EIT-team/AD9954_Current_Source/README.md

# AD9954 communication library

Communication over a serial port to program Analog Devices AD9954 DDS chip.

Arduino source code in _/Program_AD9954_.

Sample MATLAB code for programming over Serial port in _sample_code.m_

Serial commands:

  _frequency xxxx_      frequency to program (Hz)

  _stim 1_              Starts injection
  
  _stim 0_              Stops injection
