EIT-team/AD9954_Current_Source/ref/AD9954/tinadiag.jpg

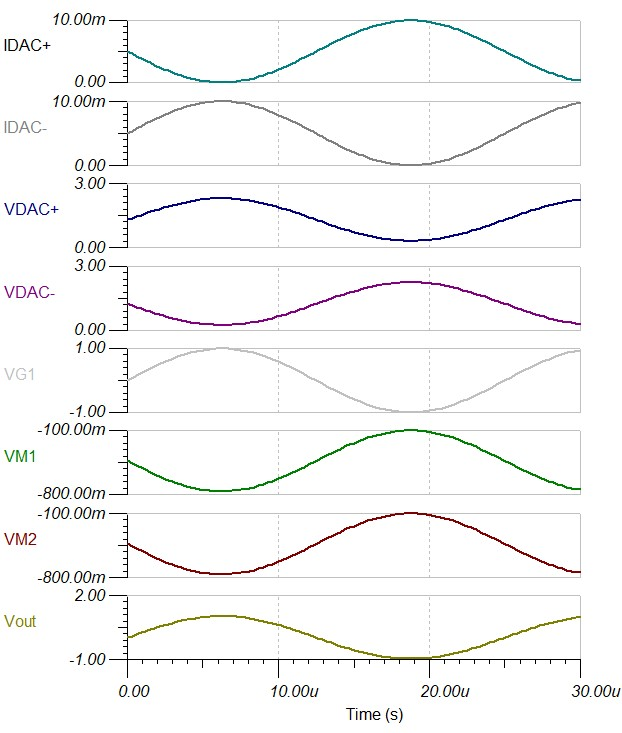
ref/AD9954/tinadiag.jpg
