EIT-team/AD9954_Current_Source/ref/AD9954/192593130AD9859_RevD_BOM_Pb_Free.xls

AD9859 REV. D-(1.0) EVALUATION BOARD Pb-Free BILL OF MATERIALS 2/08/07
ITEM | QTY | REFDES | DEVICE | PACKAGE | VALUE | MIN TOL | MFR | MFR P/N | VENDOR / DIST | P/N | COMMENTS | Pb-FREE? | BOARD ASSEMBLER Temporary Waiver
1 | 29 | C1,C2,C3, | CAP0402 | 0402 | 0.1UF, 16V, X7R | 10% | Murata | GRM155R71C104KA88D |  |  | Any Pb-Free Mfr OK | Mfr info states Yes
 |  | C4,C5,C6,
 |  | C7,C8,C9,
 |  | C10,C11,
 |  | C12,C13,
 |  | C14,C15,
 |  | C16,C17,
 |  | C18,C19,
 |  | C20,C21,
 |  | C22,C23,
 |  | C24,C68,
 |  | C69,C70,
 |  | C71,C72
2 | 4 | C25,C26, | TAJC | TAJC | 10UF, 16V, TAJ | 10% | AVX | TAJC106K016R |  |  | Any Pb-Free Mfr OK | Mfr info states Yes
 |  | C27,C28
3 | 4 | C29,C38, | CAP0805 | 0805 | 33 pF, 50 V, NPO | 5% | YAGEO | CC0805JRNPO9BN330 |  |  | Any Pb-Free Mfr OK | Mfr info states Yes
 |  | C43,C56
4 | 4 | C30,C50, | CAP0402 | 0402 | 13PF, 50V, COG | 5% | ROHM | MCH155A130JK |  |  | Any Pb-Free Mfr OK | Mfr info states Yes
 |  | C53,C59
5 | 2 | C31,C57 | CAP0805 | 0805 | 27 pF, 50V, NPO | 5% | YAGEO | CC0805JRNPO9BN270 |  |  | Any Pb-Free Mfr OK | Mfr info states Yes
6 | 5 | C32,C37, | CAP0805 | 0805 | 22 pF, 50 V, NPO | 5% | YAGEO | CC0805JRNPO9BN220 |  |  | Any Pb-Free Mfr OK | Mfr info states Yes
 |  | C41,C45,
 |  | C55
7 | 2 | C34,C61 | CAP0805 | 0805 | .01UF, 50V, X7R | 10% | KEMET | C0805C103K5RACTU
8 | 3 | C40,C42, | CAP0805 | 0805 | 39 pF, 50 V, NPO | 5% | YAGEO | CC0805JRNPO9BN390 |  |  | Any Pb-Free Mfr OK | Mfr info states Yes
 |  | C44
9 | 2 | C39,C46 | CAP1206 | 1206 | 7.5PF, 50 V, NPO | 0.5 PF | KEMET | C1206C759D5GACTU |  |  | Any Pb-Free Mfr OK | Mfr info states Yes
10 | 2 | C47,C62 | CAP0805 | 0805 | 1UF, 25V, X5R | 10% | Murata | GRM216R61E105KA12D |  |  | Any Pb-Free Mfr OK | Mfr info states Yes
11 | 4 | C48,C49, | CAP0805 | 0805 | 12 pF, 50 V, NPO | 5% | YAGEO | CC0805JRNPO9BN120 |  |  | Any Pb-Free Mfr OK | Mfr info states Yes
 |  | C63,C64
12 | 2 | C51,C54 | CAP1206 | 1206 | 2.2 pF, 50 V, NPO | 0.25 pF | YAGEO | CC1206CRNPO9BN2R2 |  |  | Any Pb-Free Mfr OK | Mfr info states Yes
13 | 2 | C52,C60 | CAP1206 | 1206 | 6.8 pF, 50 V, NPO | 0.5 pF | YAGEO | CC1206DRNPO9BN6R8 |  |  | Any Pb-Free Mfr OK | Mfr info states Yes
14 | 8 | J1,J2,J3, | SMA | SMA | N/A | N/A | Johnson Components | 142-0701-231 |  |  | Any Pb-Free Mfr OK | Mfr info states Yes
 |  | J4,J6,
 |  | J7,
 |  | J12,
 |  | J14
15 | 2 | L1,L10 |  | 1008HQ | 39 nH | 2% | Coilcraft | 1008HQ-39NXGLB |  |  | Make sure the part #'s are lead free
 |  |  |  |  |  |  |  |  |  |  | Make sure the part #'s are lead free
16 | 2 | L2,L12 |  | 1008HQ | 56 nH | 2% | Coilcraft | 1008HQ-56NXGLB |  |  | Make sure the part #'s are lead free
 |  |  |  |  |  |  |  |  |  |  | Make sure the part #'s are lead free
17 | 2 | L3,L11 |  | 1008HQ | 68 nH | 2% | Coilcraft | 1008HQ-68NXGLB |  |  | Make sure the part #'s are lead free
 |  |  |  |  |  |  |  |  |  |  | Make sure the part #'s are lead free
18 | 2 | L4,L7 |  | 0805HQ | 18NH | 5% | Coilcraft | 0805HQ-18NXJLB |  |  | Make sure the part #'s are lead free
 |  |  |  |  |  |  |  |  |  |  | Make sure the part #'s are lead free
19 | 2 | L5,L9 |  | 0805HQ | 12NH | 5% | Coilcraft | 0805HQ-12NXJLB |  |  | Make sure the part #'s are lead free
 |  |  |  |  |  |  |  |  |  |  | Make sure the part #'s are lead free
20 | 2 | L6,L8 |  | 0805HQ | 20NH | 5% | Coilcraft | 0805HQ-20NXJLB |  |  | Make sure the part #'s are lead free
21 | 7 | R1,R8, | RES_SM | 1206 | 49.9, 1/4W | 1% | Panasonic-ECG | ERJ-8ENF49R9V |  |  | Any Pb-Free Mfr OK | Mfr info states Yes
 |  | R9,R14,
 |  | R18,
 |  | R22,R23
22 | 2 | R3,R16 | RES_SM | 1206 | 243, 1/4 W | 1% | Panasonic-ECG | ERJ-8ENF2430V |  |  | Any Pb-Free Mfr OK | Mfr info states Yes
23 | 2 | R6, R7 | RES_SM | 1206 | 0, 1/4 W | 5% | Panasonic-ECG | ERJ-8GEY0R00V |  |  | Any Pb-Free Mfr OK | Mfr info states Yes
24 | 2 | R10,R15 | RES_SM | 0603 | 3.92 K, 1/10 W | 1% | Panasonic-ECG | ERJ-3EKF3921V |  |  | Any Pb-Free Mfr OK | Mfr info states Yes
25 | 4 | R33,R34, | RES_SM | 1206 | 10K, 1/4 W | 1% | Panasonic-ECG | ERJ-8ENF1002V |  |  | Any Pb-Free Mfr OK | Mfr info states Yes
 |  | R35,R37
26 | 2 | T1,T4 | ETC1_1_13 | SM22 | 1:1, 4.5-3000MHz | N/A | Tyco/M/A-COM | MABA-007159-000000 | First Source | Ph: 800-225-7434 | RF Balun (Replacement for Non-RoHS ETC1-1T-5) | Mfr info states Yes, Long lead time (?)
27 | 2 | T2,T3 | TFORM | KK81 | 1:1, 0.08-300MHz | N/A | Mini-Circuits | T1-1T-KK81+ |  |  | RF Transformer | "+" = Pb-Free
28 | 1 | U3 | TB5 | TB5 | 5 PIN |  | Weiland | Terminal Strip Z5.530.3525.0 |  |  | Order Plug and Terminal Strip (2 Items) | Mfr info states Yes
 |  |  |  |  |  |  | Weiland | Plug 25.602.2553.0
29 | 1 | U4 | C36CRPX | 36CRP | N/A | N/A | TYCO Electronics | 5552742-1 |  |  |  | Mfr info states Yes
30 | 1 | U6 | 74LVC125A | TSSOP14 | N/A | N/A | Texas Instruments | SN74LVC125APW | Digi-Key |  | Any Pb-Free Mfr OK | Mfr info states Yes
31 | 2 | U7,U8 | AD9859 | 48 Lead TQFP | N/A | N/A | Analog Devices, Inc. | AD9859YSVZ |  |  |  | Mfr info states Yes
32 | 3 | U9,U10,U11 | 74LVC574APW | TSSOP20 | N/A | N/A | Texas Instruments | SN74LVC574APW | Digi-Key |  |  | Mfr info states Yes
33 | 1 | U12 | 74LVC14A | TSSOP14 | N/A | N/A | Texas Instruments | SN74LVC14APW | Digi-Key |  | Any Pb-Free Mfr OK | Mfr info states Yes
34 | 1 | U13 | 50PINHEAD | HEADER | N/A | N/A | Samtec | TSW-125-23-L-D |  |  |  | Mfr info states Yes
35 | 2 | W1,W3 | SMT TERM STP | NORM_J | N/A | N/A | Samtec | TSM-102-01-L-DV |  |  |  | Mfr info states Yes
36 | 1 | W2 | 3PINHDR | SIP-3P | N/A | N/A | Samtec | TSW-103-07-S-S |  |  | Header | Mfr info states Yes
37 | 3 | (none) | 2PINHDR | SIP-2P | N/A | N/A | Samtec | TSW-102-07-S-S |  |  | Header (Mount to PC Control Side of W2, Across | Mfr info states Yes
 |  |  |  |  |  |  |  |  |  |  | 1 to 2, of W1, and W3)
38 | 2 | (none) | TEST POINTS |  | N/A | N/A | Keystone Electronics | 5000 | Digi-Key |  | Mount at "SYNC CLK DUT1, SYNC CLK DUT 2" | Mfr info states Yes
39 | 5 | N/A | Adhesive Feet | N/A | Black | N/A | 3M | SJ-5518 | Digi-Key | SJ5518-0-ND | Install on Bottom, 4 Corners, One in PC Board Center | Mfr info states Yes
40 | 1 | N/A | PCB | N/A | N/A | N/A | MOOG Components Grp. | AD9859/PCBZ |  |  |  | Mfr info states Yes
 |  |  |  |  |  |  |  | Eval Board (Rev. D)
