EIT-team/AD9954_Current_Source/(threads)

Thread 1 (2019-06-13):

Rev3 Changes

Jimbles, 2019-06-13:
- Switch to crystal 20 MHz oscillator
- Change DAC values
- Better/smaller 1.8V LDOs?
- Better connection for current output
