EIT-team/AD9954_Current_Source/ref/AD9954/46543170023221AD9954_RevD_schem.pdf

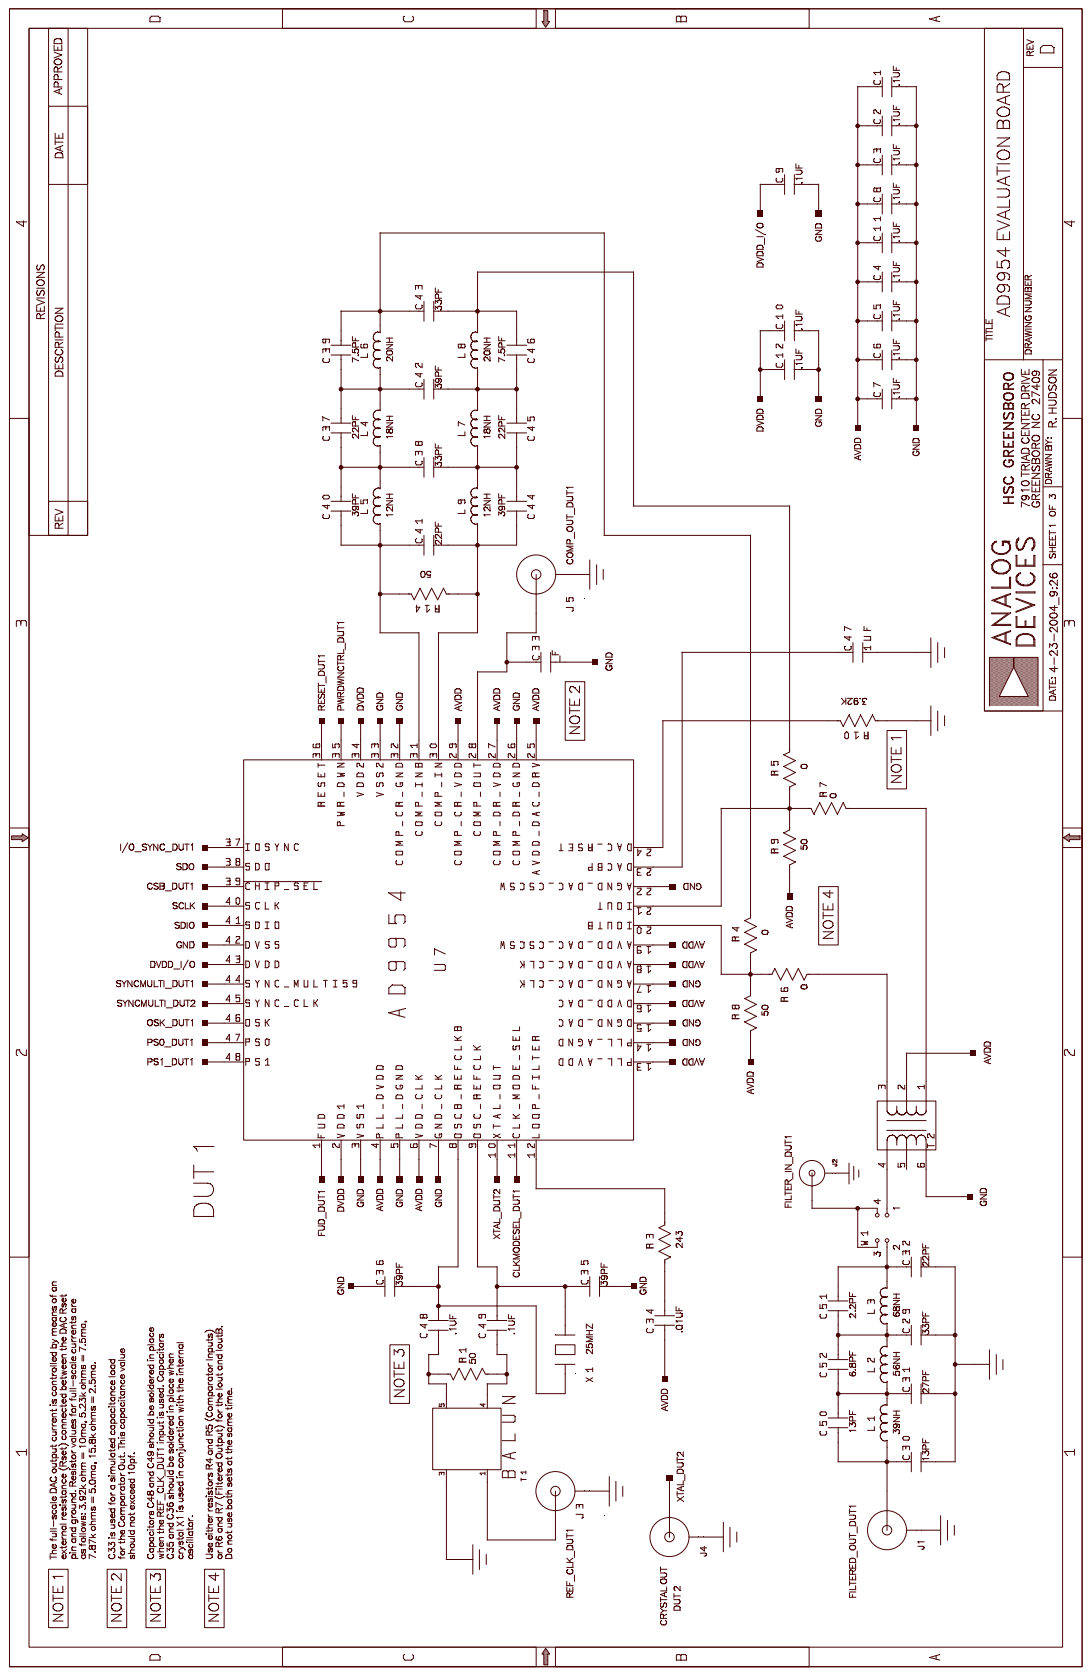
[picture p2: page 1]

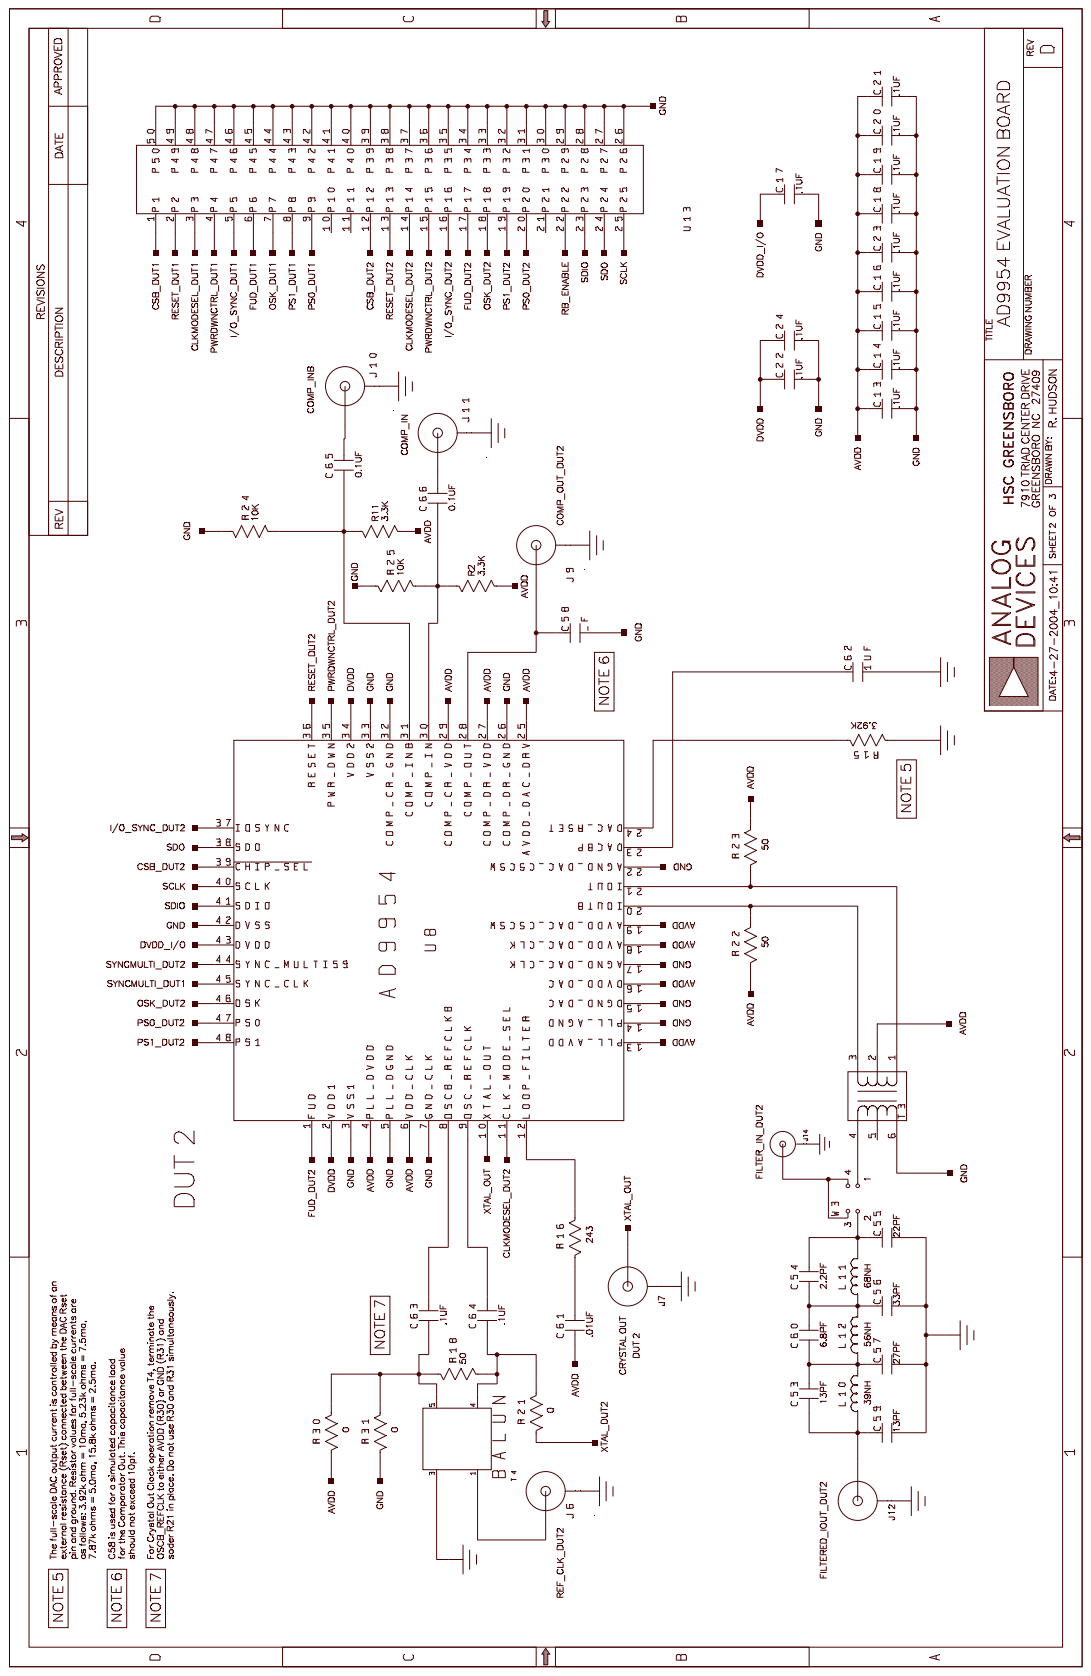
[picture p3: page 2]

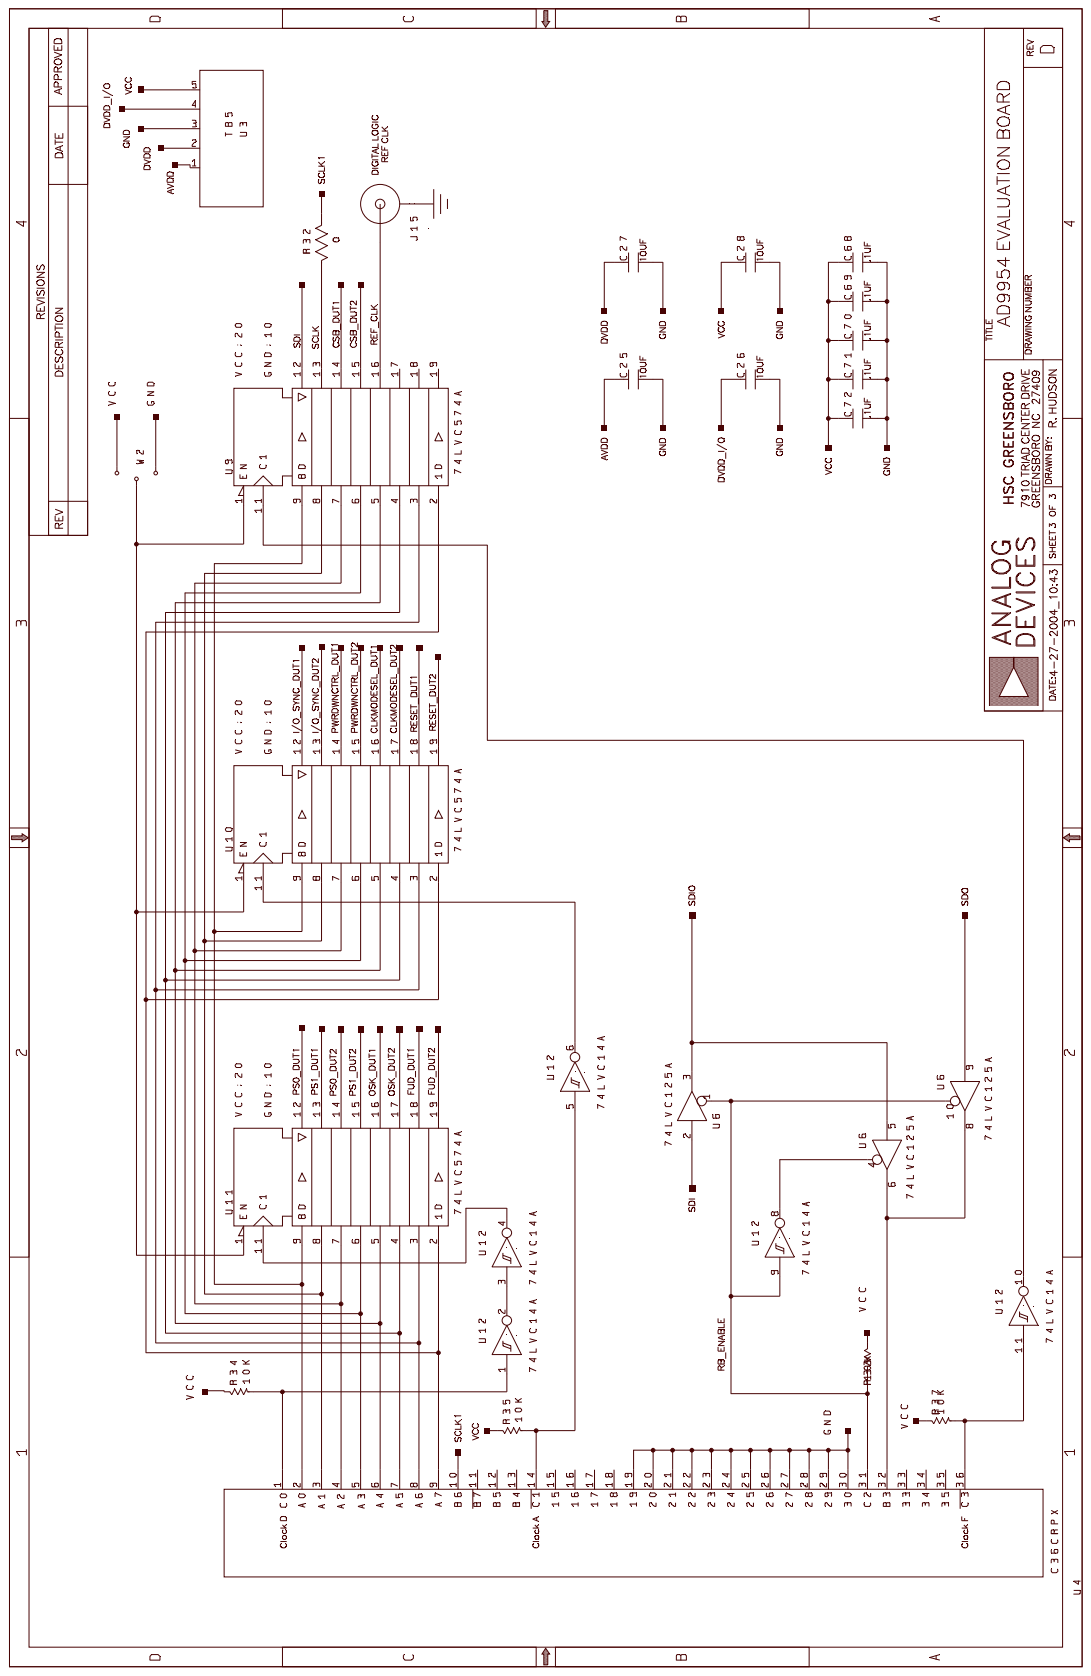
[picture p4: page 3]
