EIT-team/AD9954_Current_Source/ref/AD9954/DAC_Network_Model.asc

I1: current; SINE(2.5m 2.5m 1000 0 0 0)
I2: current; SINE(2.5m 2.5m 1000 0 0 180)
R1: res; 931
R2: res; 1500
R3: res; 750
R4: res; 1150
Rf: res; 750
Rg: res; 1500
Rx: res; 287
Ry: res; 309
U1: opamp
V1: voltage; 3.3
V2: voltage; 1.8
Named nets: 0, Vref, Vout, VDAC+, VDAC-, VIN+, VIN-, VDD
.tran 0 2m 0
.lib opamp.sub
;op 0 2m 0
