EIT-team/AD9954_Current_Source/schematics/rev2/ScouseTom_CS_Shield.brd

## EAGLE design schematics/rev2/ScouseTom_CS_Shield.brd (2019-02-04)

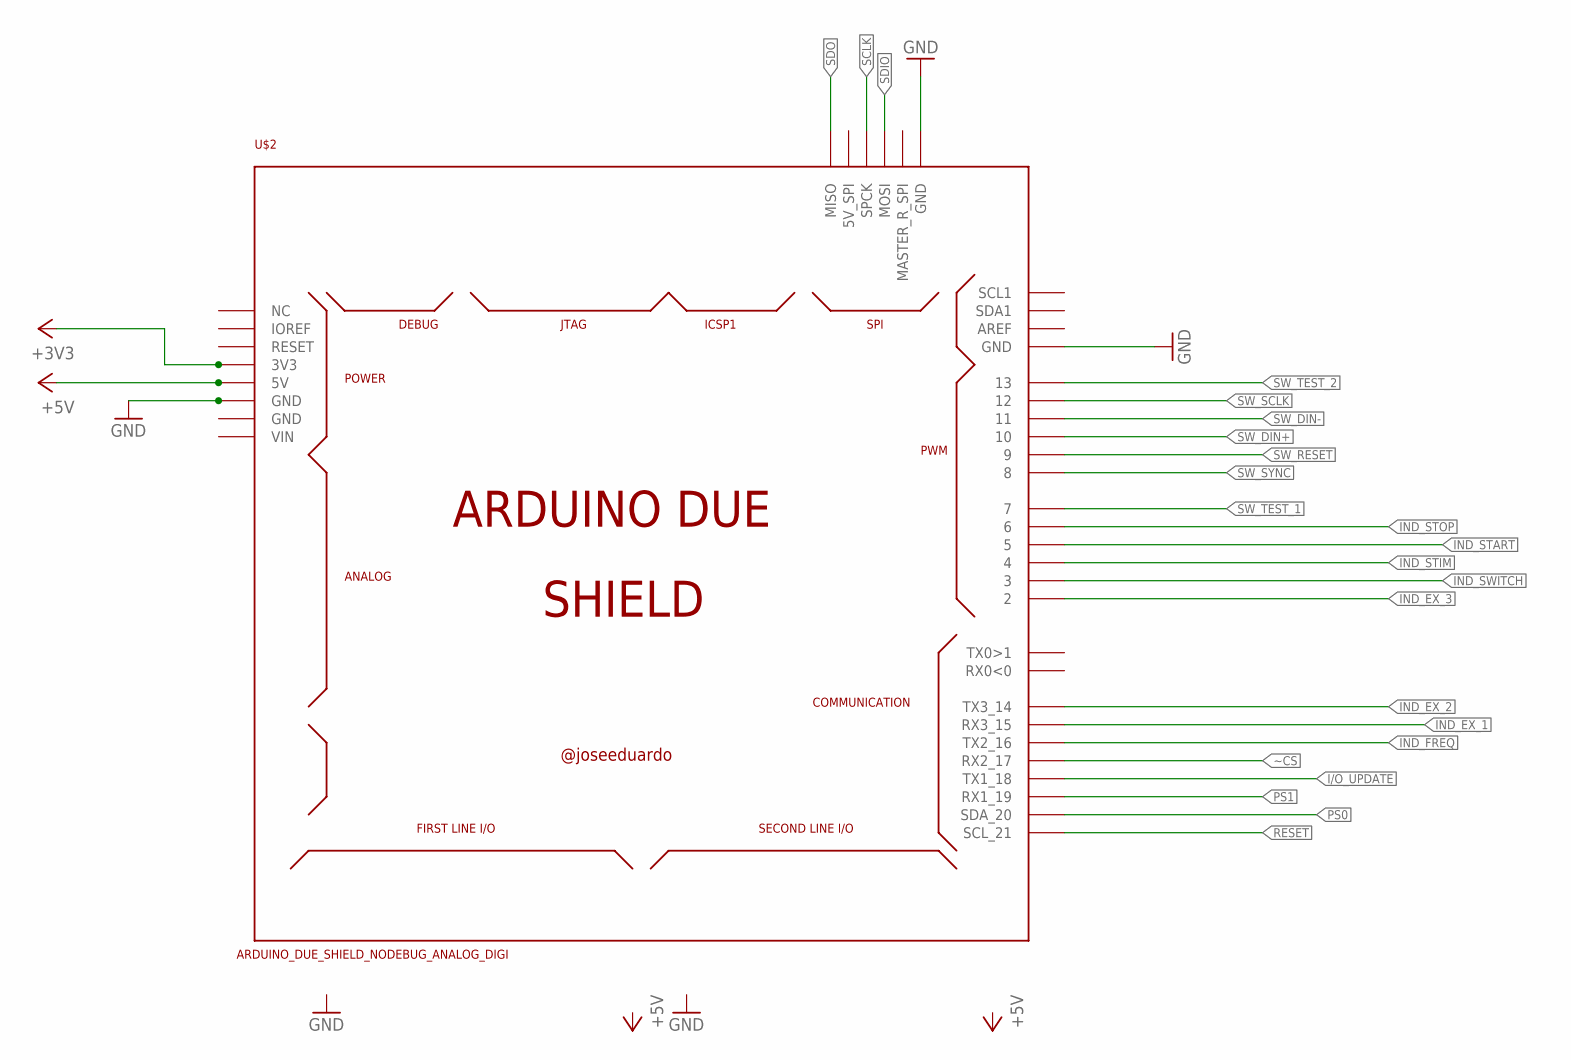
[picture p5: schematic ScouseTom_CS_Shield.sch, sheet 1, Arduino]

Parts:
U$2: ARDUINO_DUE_SHIELD_NODEBUG_ANALOG_DIGI; ARDUINO_DUE_SHIELD_NODEBUG_ANALOG_DIG

Connections:
+3V3: U$2.3V3; also elsewhere on the board
+5V: U$2.5V0 (5V); also elsewhere on the board
GND: U$2.GND, U$2.GND_4 (GND), U$2.GND_5 (GND); also elsewhere on the board
I/O_UPDATE: U$2.18 (TX1_18); also elsewhere on the board
IND_EX_1: U$2.15 (RX3_15); also elsewhere on the board
IND_EX_2: U$2.14 (TX3_14); also elsewhere on the board
IND_EX_3: U$2.2; also elsewhere on the board
IND_FREQ: U$2.16 (TX2_16); also elsewhere on the board
IND_START: U$2.5; also elsewhere on the board
IND_STIM: U$2.4; also elsewhere on the board
IND_STOP: U$2.6; also elsewhere on the board
IND_SWITCH: U$2.3; also elsewhere on the board
PS0: U$2.20 (SDA_20); also elsewhere on the board
PS1: U$2.19 (RX1_19); also elsewhere on the board
RESET: U$2.21 (SCL_21); also elsewhere on the board
SCLK: U$2.SPCK; also elsewhere on the board
SDIO: U$2.MOSI; also elsewhere on the board
SDO: U$2.MISO; also elsewhere on the board
SW_DIN+: U$2.10; also elsewhere on the board
SW_DIN-: U$2.11; also elsewhere on the board
SW_RESET: U$2.9; also elsewhere on the board
SW_SCLK: U$2.12; also elsewhere on the board
SW_SYNC: U$2.8; also elsewhere on the board
SW_TEST_1: U$2.7; also elsewhere on the board
SW_TEST_2: U$2.13; also elsewhere on the board
~CS: U$2.17 (RX2_17); also elsewhere on the board

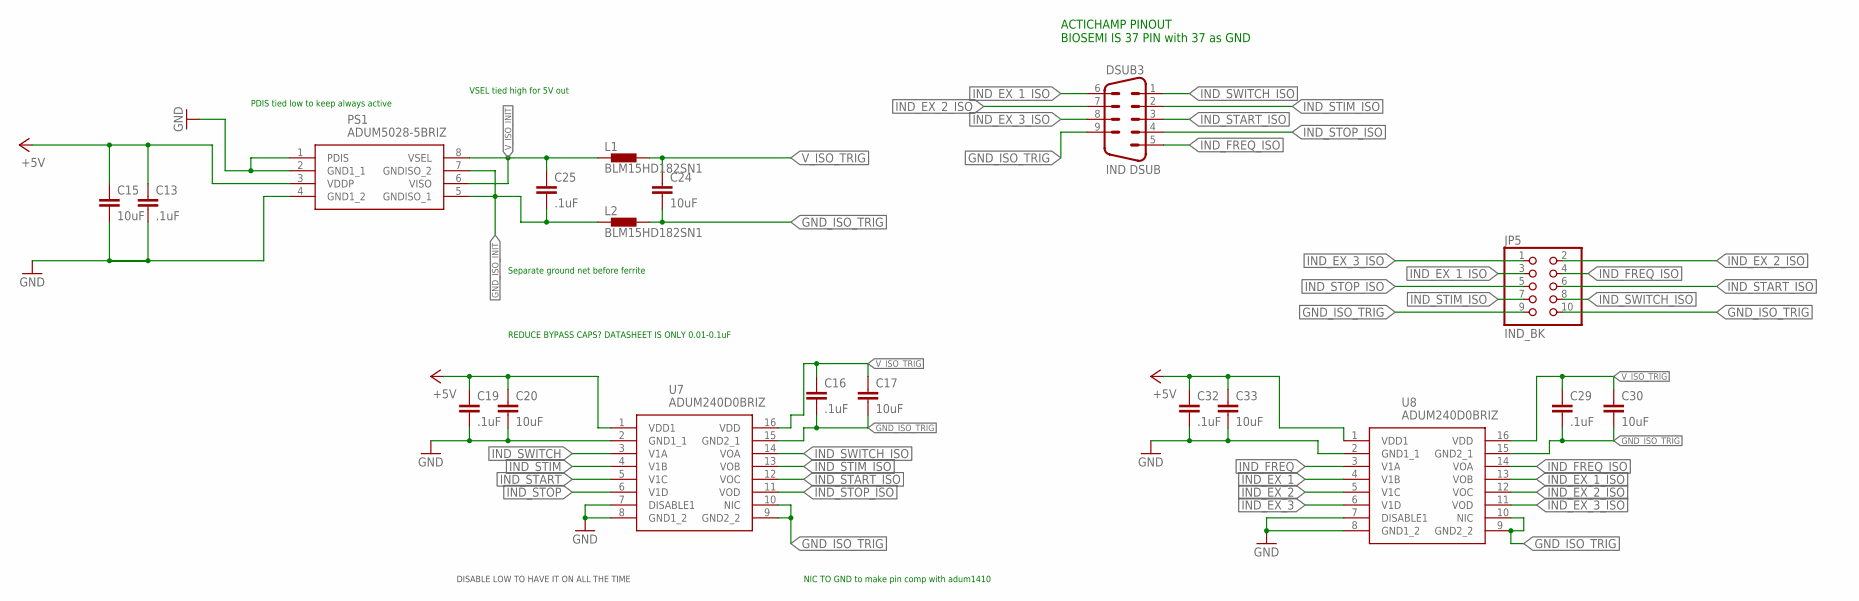
[picture p6: schematic ScouseTom_CS_Shield.sch, sheet 2, Indicators]

Parts:
C13, C16, C19, C25, C29, C32: .1uF; C0805
C15, C17, C20, C24, C30, C33: 10uF; C0805
DSUB3: IND DSUB; DSUB9
JP5: IND_BK; 2X05
L1, L2: BLM15HD182SN1; 0402
PS1: ADUM5028-5BRIZ; SOIC127P1031X265-8N
U7, U8: ADUM240D0BRIZ; SOIC127P1032X265-16N

Connections:
+5V: C13.1, C15.1, C19.1, C20.1, C32.1, C33.1, PS1.3 (VDDP), U7.1 (VDD1), U8.1 (VDD1); also elsewhere on the board
GND: C13.2, C15.2, C19.2, C20.2, C32.2, C33.2, PS1.1 (PDIS), PS1.2 (GND1_1), PS1.4 (GND1_2), U7.2 (GND1_1), U7.7 (DISABLE1), U7.8 (GND1_2), U8.2 (GND1_1), U8.7 (DISABLE1), U8.8 (GND1_2); also elsewhere on the board
GND_ISO_INIT: C25.2, L2.1, PS1.5 (GNDISO_1), PS1.7 (GNDISO_2)
GND_ISO_TRIG: C16.2, C17.2, C24.2, C29.2, C30.2, DSUB3.9, JP5.9, JP5.10, L2.2, U7.9 (GND2_2), U7.10 (NIC), U7.15 (GND2_1), U8.9 (GND2_2), U8.10 (NIC), U8.15 (GND2_1)
IND_EX_1: U8.4 (V1B); also elsewhere on the board
IND_EX_1_ISO: DSUB3.6, JP5.3, U8.13 (VOB)
IND_EX_2: U8.5 (V1C); also elsewhere on the board
IND_EX_2_ISO: DSUB3.7, JP5.2, U8.12 (VOC)
IND_EX_3: U8.6 (V1D); also elsewhere on the board
IND_EX_3_ISO: DSUB3.8, JP5.1, U8.11 (VOD)
IND_FREQ: U8.3 (V1A); also elsewhere on the board
IND_FREQ_ISO: DSUB3.5, JP5.4, U8.14 (VOA)
IND_START: U7.5 (V1C); also elsewhere on the board
IND_START_ISO: DSUB3.3, JP5.6, U7.12 (VOC)
IND_STIM: U7.4 (V1B); also elsewhere on the board
IND_STIM_ISO: DSUB3.2, JP5.7, U7.13 (VOB)
IND_STOP: U7.6 (V1D); also elsewhere on the board
IND_STOP_ISO: DSUB3.4, JP5.5, U7.11 (VOD)
IND_SWITCH: U7.3 (V1A); also elsewhere on the board
IND_SWITCH_ISO: DSUB3.1, JP5.8, U7.14 (VOA)
V_ISO_INIT: C25.1, L1.1, PS1.6 (VISO), PS1.8 (VSEL)
V_ISO_TRIG: C16.1, C17.1, C24.1, C29.1, C30.1, L1.2, U7.16 (VDD), U8.16 (VDD)

Notes on the sheet:
ACTICHAMP PINOUT BIOSEMI IS 37 PIN with 37 as GND
NIC TO GND to make pin comp with adum1410
REDUCE BYPASS CAPS? DATASHEET IS ONLY 0.01-0.1uF
PDIS tied low to keep always active
VSEL tied high for 5V out
Separate ground net before ferrite
DISABLE LOW TO HAVE IT ON ALL THE TIME

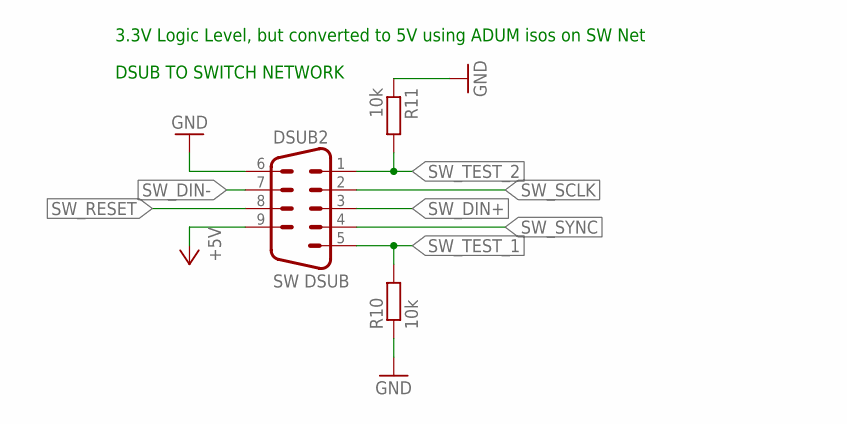
[picture p7: schematic ScouseTom_CS_Shield.sch, sheet 3, Switch]

Parts:
DSUB2: SW DSUB; DSUB9
R10, R11: 10k; R0805

Connections:
+5V: DSUB2.9; also elsewhere on the board
GND: DSUB2.6, R10.1, R11.1; also elsewhere on the board
SW_DIN+: DSUB2.3; also elsewhere on the board
SW_DIN-: DSUB2.7; also elsewhere on the board
SW_RESET: DSUB2.8; also elsewhere on the board
SW_SCLK: DSUB2.2; also elsewhere on the board
SW_SYNC: DSUB2.4; also elsewhere on the board
SW_TEST_1: DSUB2.5, R10.2; also elsewhere on the board
SW_TEST_2: DSUB2.1, R11.2; also elsewhere on the board

Notes on the sheet:
DSUB TO SWITCH NETWORK
3.3V Logic Level, but converted to 5V using ADUM isos on SW Net

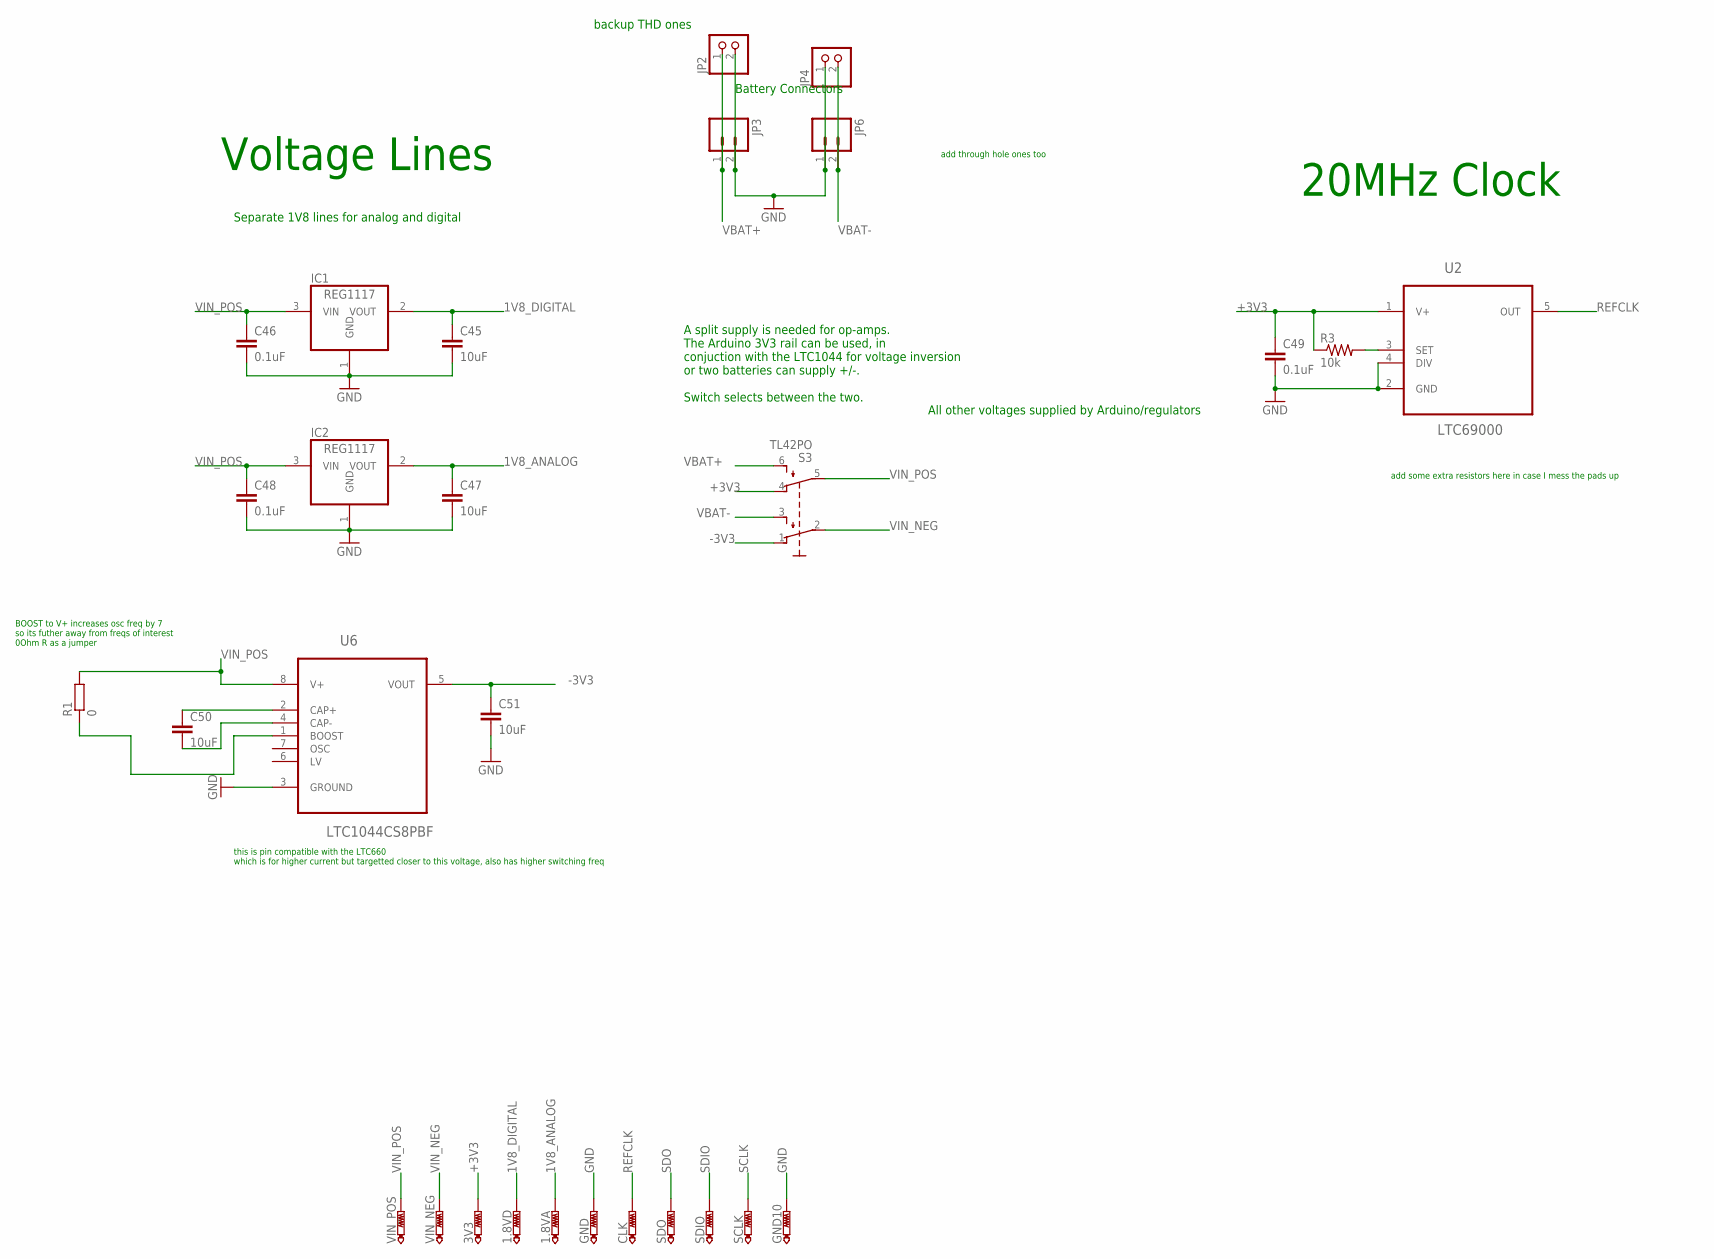
[picture p8: schematic ScouseTom_CS_Shield.sch, sheet 4, AD99554 Power and Clock]

Parts:
1.8VA, 1.8VD, 3V3: PTR1PAD1-13; P1-13
C45, C47, C50, C51: 10uF; C0603
C46, C48, C49: 0.1uF; C0603
CLK: PTR1PAD1-13; P1-13
GND, GND10: PTR1PAD1-13; P1-13
IC1, IC2: REG1117; SOT223
JP2, JP4: PINHD-1X2; 1X02
JP3, JP6: M02-JST-2MM-SMT; JST-2-SMD
R1: 0; R0805
R3: 10k; R0805
S3: TL42PO; TL4XPO
SCLK: PTR1PAD1-13; P1-13
SDIO: PTR1PAD1-13; P1-13
SDO: PTR1PAD1-13; P1-13
U2: LTC69000; SOT23-5L
U6: LTC1044CS8PBF; SOIC127P600X175-8N
VIN_NEG: PTR1PAD1-13; P1-13
VIN_POS: PTR1PAD1-13; P1-13

Connections:
1V8_ANALOG: 1.8VA.TP, C47.1, IC2.2 (VOUT); also elsewhere on the board
1V8_DIGITAL: 1.8VD.TP, C45.1, IC1.2 (VOUT); also elsewhere on the board
+3V3: 3V3.TP, C49.1, R3.1, S3.4 (O1), U2.1 (V+); also elsewhere on the board
-3V3: C51.1, S3.1 (O), U6.5 (VOUT)
GND: C45.2, C46.2, C47.2, C48.2, C49.2, C51.2, GND.TP, GND10.TP, IC1.1 (GND), IC2.1 (GND), JP2.2, JP3.2, JP4.1, JP6.1, U2.2 (GND), U2.4 (DIV), U6.3 (GROUND); also elsewhere on the board
unnamed: R1.1, U6.1 (BOOST)
unnamed: C50.1, U6.2 (CAP+)
unnamed: R3.2, U2.3 (SET)
unnamed: C50.2, U6.4 (CAP-)
REFCLK: CLK.TP, U2.5 (OUT); also elsewhere on the board
SCLK: SCLK.TP; also elsewhere on the board
SDIO: SDIO.TP; also elsewhere on the board
SDO: SDO.TP; also elsewhere on the board
VBAT+: JP2.1, JP3.1, S3.6 (S1)
VBAT-: JP4.2, JP6.2, S3.3 (S)
VIN_NEG: S3.2, VIN_NEG.TP; also elsewhere on the board
VIN_POS: C46.1, C48.1, IC1.3 (VIN), IC2.3 (VIN), R1.2, S3.5 (P1), U6.8 (V+), VIN_POS.TP; also elsewhere on the board

Notes on the sheet:
Separate 1V8 lines for analog and digital
Voltage Lines
20MHz Clock
A split supply is needed for op-amps. The Arduino 3V3 rail can be used, in conjuction with the LTC1044 for voltage inversion or two batteries can supply +/-. Switch selects between the two.
Battery Connectors
All other voltages supplied by Arduino/regulators
add some extra resistors here in case I mess the pads up
add through hole ones too
this is pin compatible with the LTC660 which is for higher current but targetted closer to this voltage, also has higher switching freq
BOOST to V+ increases osc freq by 7 so its futher away from freqs of interest 0Ohm R as a jumper
backup THD ones

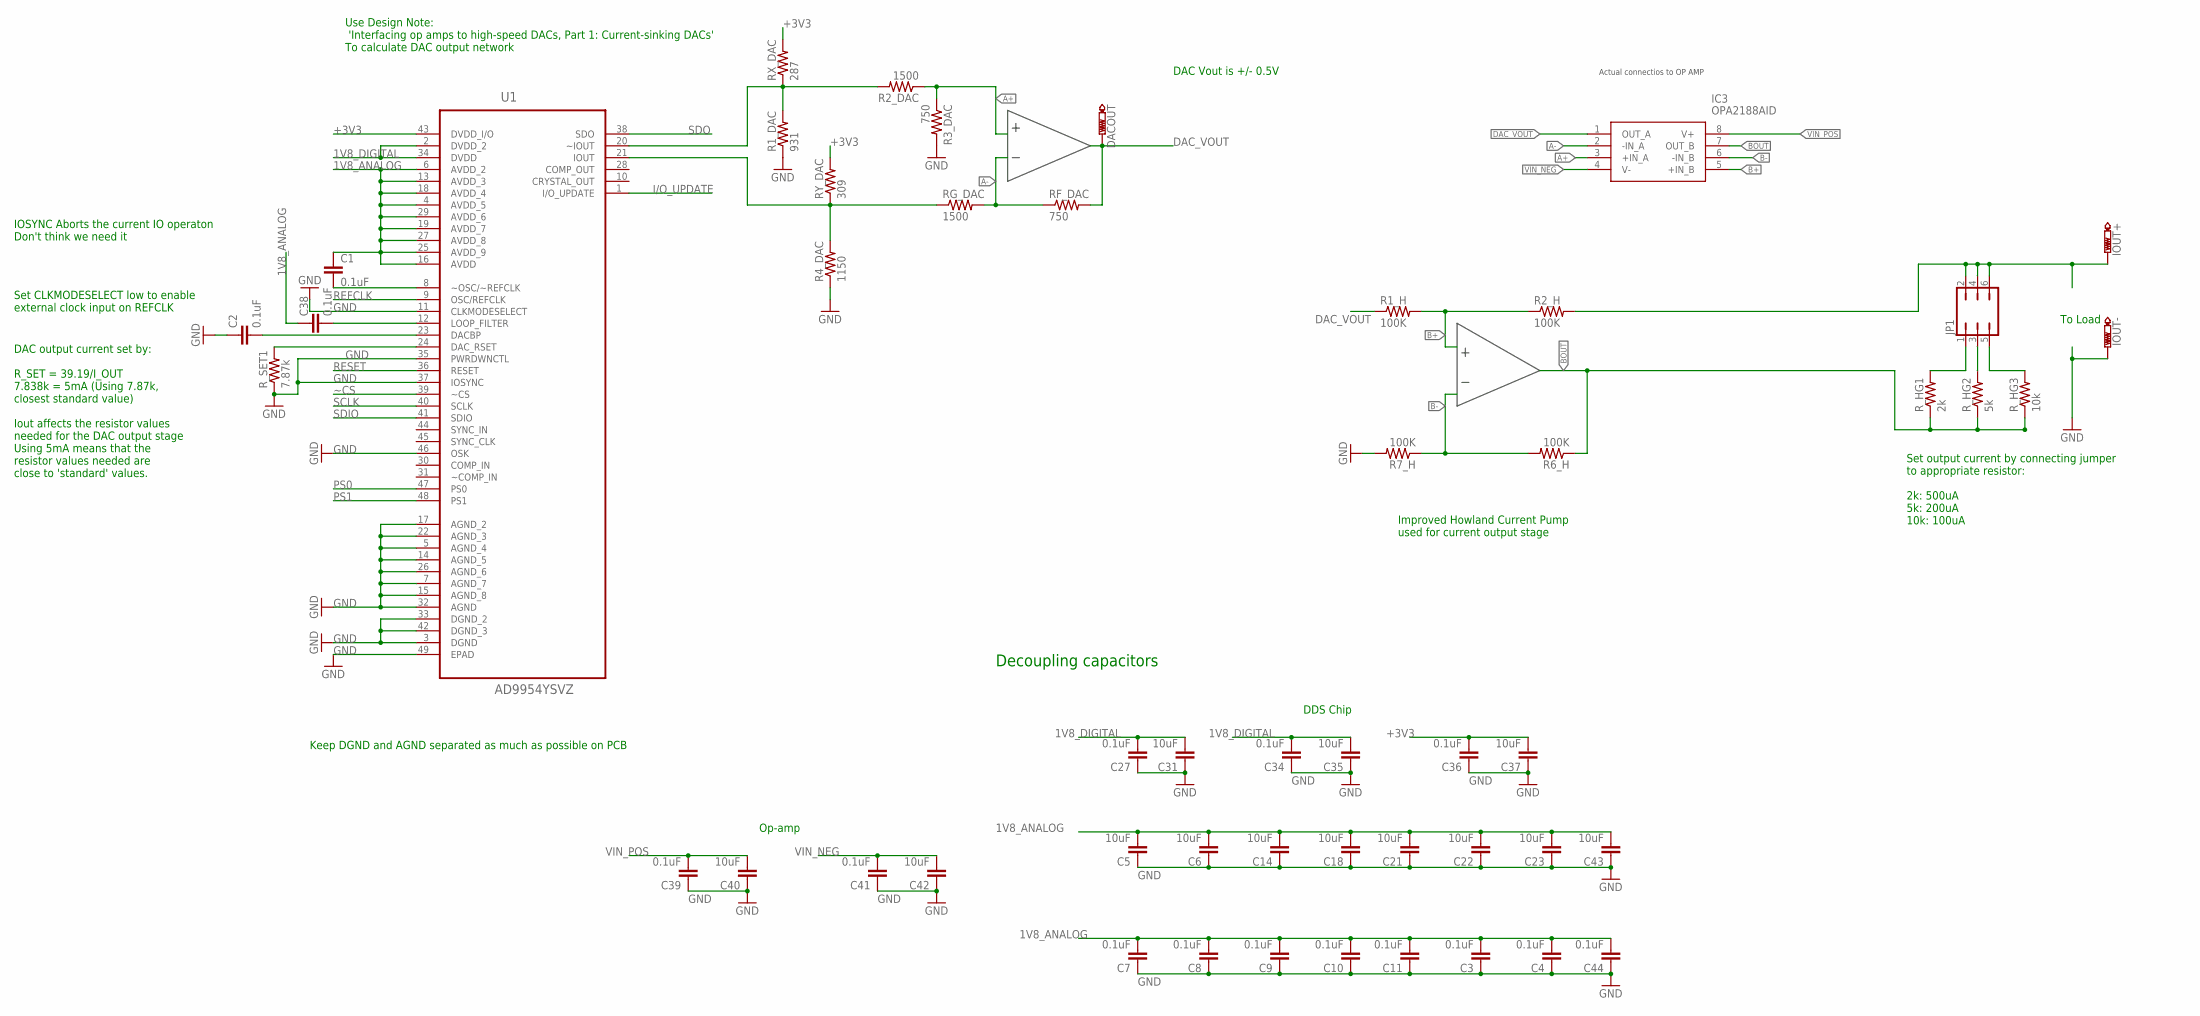
[picture p9: schematic ScouseTom_CS_Shield.sch, sheet 5, DAC and HCP]

Parts:
C1, C2, C3, C4, C7, C8, C9, C10, C11, C27, C34, C36, C38, C39, C41, C44: 0.1uF; C0603
C5, C6, C14, C18, C21, C22, C23, C31, C35, C37, C40, C42, C43: 10uF; C0603
DACOUT: PTR1PAD1-13; P1-13
IC3: OPA2188AID; SOIC127P600X175-8N
IOUT+: PTR1PAD1-13; P1-13
IOUT-: PTR1PAD1-13; P1-13
JP1: JP3Q
R1_DAC: 931; R0805
R1_H, R2_H, R6_H, R7_H: 100K; R0805
R2_DAC: 1500; R0805
R3_DAC: 750; R0805
R4_DAC: 1150; R0805
RF_DAC: 750; R0805
RG_DAC: 1500; R0805
RX_DAC: 287; R0805
RY_DAC: 309; R0805
R_HG1: 2k; R0805
R_HG2: 5k; R0805
R_HG3: 10k; R0805
R_SET1: 7.87k; R0805
U1: AD9954YSVZ; QFP50P900X900X120-49N

Connections:
1V8_ANALOG: C1.1, C3.2, C4.2, C5.2, C6.2, C7.2, C8.2, C9.2, C10.2, C11.2, C14.2, C18.2, C21.2, C22.2, C23.2, C38.1, C43.2, C44.2, U1.4 (AVDD_5), U1.6 (AVDD_2), U1.13 (AVDD_3), U1.16 (AVDD), U1.18 (AVDD_4), U1.19 (AVDD_7), U1.25 (AVDD_9), U1.27 (AVDD_8), U1.29 (AVDD_6); also elsewhere on the board
1V8_DIGITAL: C27.2, C31.2, C34.2, C35.2, U1.2 (DVDD_2), U1.34 (DVDD); also elsewhere on the board
+3V3: C36.2, C37.2, RX_DAC.2, RY_DAC.2, U1.43 (DVDD_I/O); also elsewhere on the board
A+: IC3.3 (+IN_A), R2_DAC.1, R3_DAC.1
A-: IC3.2 (-IN_A), RF_DAC.1, RG_DAC.2
B+: IC3.5 (+IN_B), R1_H.2, R2_H.1
B-: IC3.6 (-IN_B), R6_H.2, R7_H.1
BOUT: IC3.7 (OUT_B), R6_H.1, R_HG1.1, R_HG2.1, R_HG3.1
DAC_VOUT: DACOUT.TP, IC3.1 (OUT_A), R1_H.1, RF_DAC.2
GND: C2.1, C3.1, C4.1, C5.1, C6.1, C7.1, C8.1, C9.1, C10.1, C11.1, C14.1, C18.1, C21.1, C22.1, C23.1, C27.1, C31.1, C34.1, C35.1, C36.1, C37.1, C39.1, C40.1, C41.1, C42.1, C43.1, C44.1, IOUT-.TP, R1_DAC.1, R3_DAC.2, R4_DAC.1, R7_H.2, R_SET1.1, U1.3 (DGND), U1.5 (AGND_4), U1.7 (AGND_7), U1.11 (CLKMODESELECT), U1.14 (AGND_5), U1.15 (AGND_8), U1.17 (AGND_2), U1.22 (AGND_3), U1.26 (AGND_6), U1.32 (AGND), U1.33 (DGND_2), U1.35 (PWRDWNCTL), U1.37 (IOSYNC), U1.42 (DGND_3), U1.46 (OSK), U1.49 (EPAD); also elsewhere on the board
I/O_UPDATE: U1.1 (I/O_UPDATE); also elsewhere on the board
IOUT: R4_DAC.2, RG_DAC.1, RY_DAC.1, U1.21 (IOUT)
unnamed: C2.2, U1.23 (DACBP)
unnamed: C1.2, U1.8 (~OSC/~REFCLK)
unnamed: R_SET1.2, U1.24 (DAC_RSET)
unnamed: C38.2, U1.12 (LOOP_FILTER)
unnamed: IOUT+.TP, JP1.2, JP1.4, JP1.6, R2_H.2
unnamed: JP1.3, R_HG2.2
unnamed: JP1.5, R_HG3.2
unnamed: JP1.1, R_HG1.2
PS0: U1.47 (PS0); also elsewhere on the board
PS1: U1.48 (PS1); also elsewhere on the board
REFCLK: U1.9 (OSC/REFCLK); also elsewhere on the board
RESET: U1.36 (RESET); also elsewhere on the board
SCLK: U1.40 (SCLK); also elsewhere on the board
SDIO: U1.41 (SDIO); also elsewhere on the board
SDO: U1.38 (SDO); also elsewhere on the board
VIN_NEG: C41.2, C42.2, IC3.4 (V-); also elsewhere on the board
VIN_POS: C39.2, C40.2, IC3.8 (V+); also elsewhere on the board
~CS: U1.39 (~CS); also elsewhere on the board
~IOUT: R1_DAC.2, R2_DAC.2, RX_DAC.1, U1.20 (~IOUT)

Notes on the sheet:
Set CLKMODESELECT low to enable external clock input on REFCLK
DAC output current set by: R_SET = 39.19/I_OUT 7.838k = 5mA (Using 7.87k, closest standard value) Iout affects the resistor values needed for the DAC output stage Using 5mA means that the resistor values needed are close to 'standard' values.
IOSYNC Aborts the current IO operaton Don't think we need it
Decoupling capacitors
Use Design Note: 'Interfacing op amps to high-speed DACs, Part 1: Current-sinking DACs' To calculate DAC output network
Keep DGND and AGND separated as much as possible on PCB
DAC Vout is +/- 0.5V
DDS Chip
Op-amp
Set output current by connecting jumper to appropriate resistor: 2k: 500uA 5k: 200uA 10k: 100uA
To Load
Improved Howland Current Pump used for current output stage
Actual connectios to OP AMP

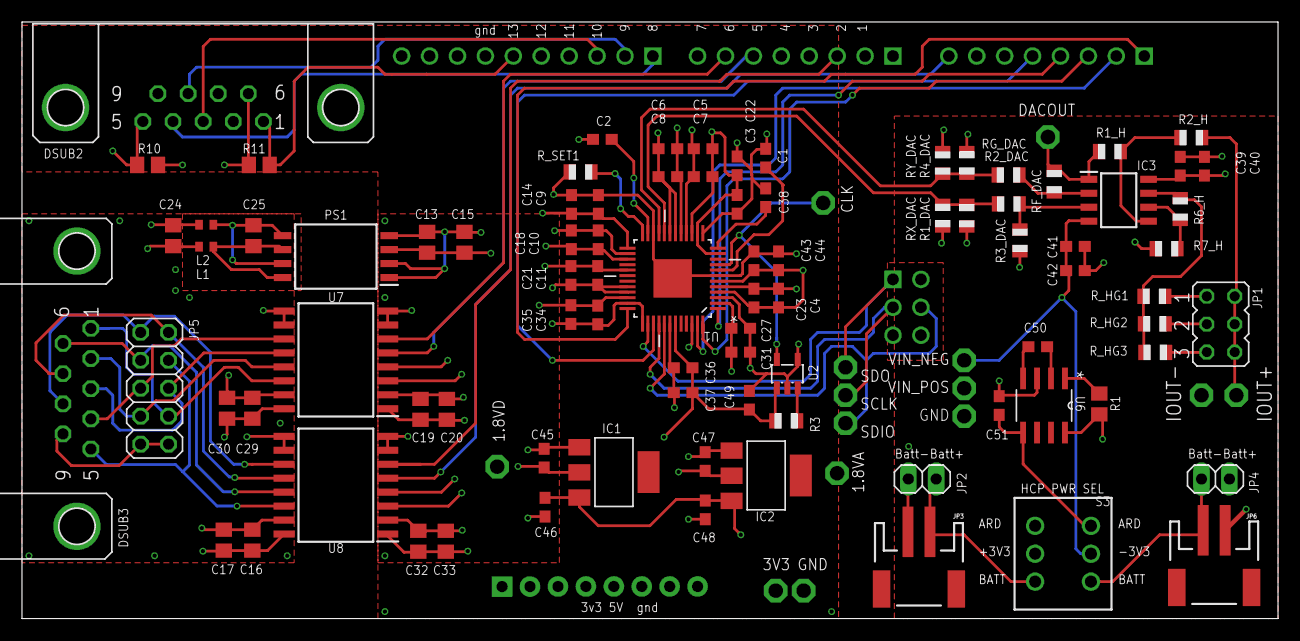
[picture p10: board ScouseTom_CS_Shield.brd from above]

Board: 4 copper layers, 114.3 x 54.3 mm, 103 parts (0 on the bottom side), 66 nets.
