EIT-team/AD9954_Current_Source/schematics/rev1/Low.Noise.Current.Source.brd

## EAGLE design schematics/rev1/Low.Noise.Current.Source.brd (2019-01-07, an earlier design)

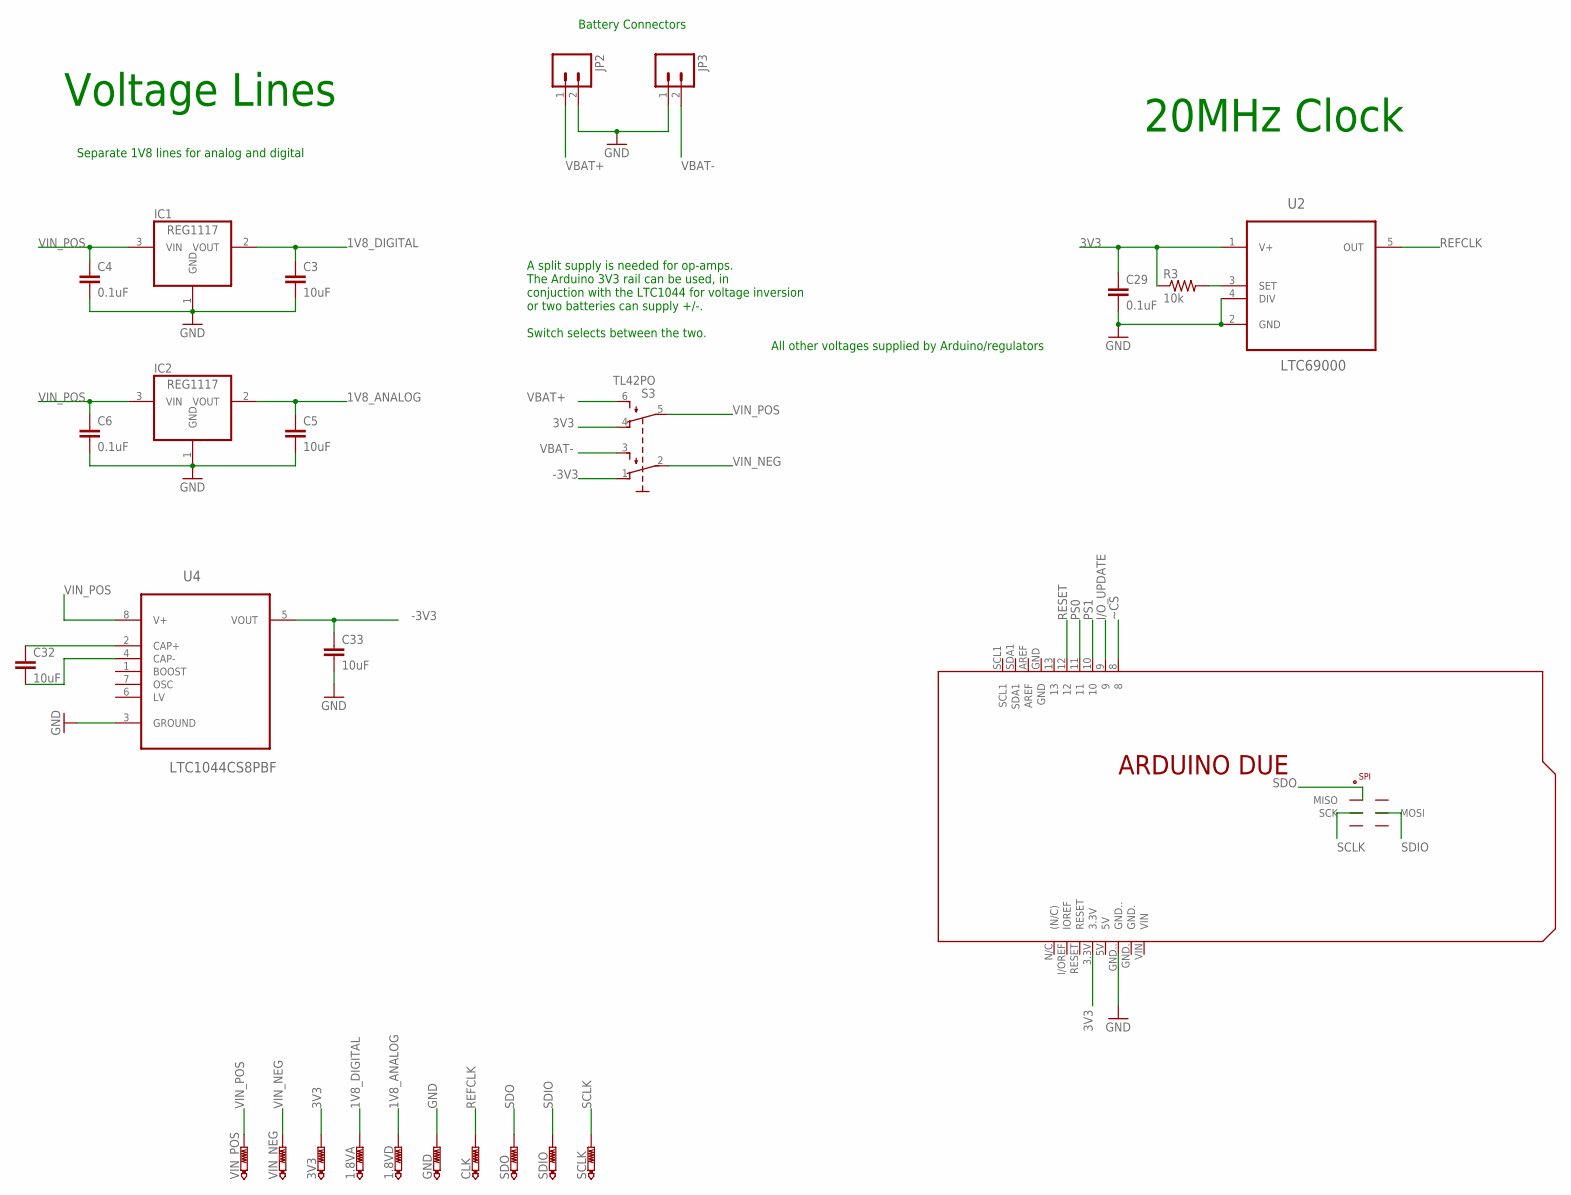
[picture p11: schematic Low.Noise.Current.Source.sch, sheet 1]

Parts:
1.8VA, 1.8VD, 3V3: PTR1PAD1-13; P1-13
C3, C5, C32, C33: 10uF; C0603
C4, C6, C29: 0.1uF; C0603
CLK: PTR1PAD1-13; P1-13
GND: PTR1PAD1-13; P1-13
IC1, IC2: REG1117; SOT223
JP2, JP3: M02-JST-2MM-SMT; JST-2-SMD
PCB1: ARDUINO_DUE
R3: 10k; R0805
S3: TL42PO; TL4XPO
SCLK: PTR1PAD1-13; P1-13
SDIO: PTR1PAD1-13; P1-13
SDO: PTR1PAD1-13; P1-13
U2: LTC69000; SOT23-5L
U4: LTC1044CS8PBF; SOIC127P600X175-8N
VIN_NEG: PTR1PAD1-13; P1-13
VIN_POS: PTR1PAD1-13; P1-13

Connections:
1V8_ANALOG: 1.8VD.TP, C5.1, IC2.2 (VOUT); also elsewhere on the board
1V8_DIGITAL: 1.8VA.TP, C3.1, IC1.2 (VOUT); also elsewhere on the board
3V3: 3V3.TP, C29.1, PCB1.3.3V, R3.1, S3.4 (O1), U2.1 (V+); also elsewhere on the board
-3V3: C33.1, S3.1 (O), U4.5 (VOUT)
GND: C3.2, C4.2, C5.2, C6.2, C29.2, C33.2, GND.TP, IC1.1 (GND), IC2.1 (GND), JP2.2, JP3.1, PCB1.GND.., U2.2 (GND), U2.4 (DIV), U4.3 (GROUND); also elsewhere on the board
I/O_UPDATE: PCB1.9; also elsewhere on the board
unnamed: C32.1, U4.2 (CAP+)
unnamed: R3.2, U2.3 (SET)
unnamed: C32.2, U4.4 (CAP-)
PS0: PCB1.11; also elsewhere on the board
PS1: PCB1.10; also elsewhere on the board
REFCLK: CLK.TP, U2.5 (OUT); also elsewhere on the board
RESET: PCB1.12; also elsewhere on the board
SCLK: PCB1.SCK, SCLK.TP; also elsewhere on the board
SDIO: PCB1.MOSI, SDIO.TP; also elsewhere on the board
SDO: PCB1.MISO, SDO.TP; also elsewhere on the board
VBAT+: JP2.1, S3.6 (S1)
VBAT-: JP3.2, S3.3 (S)
VIN_NEG: S3.2, VIN_NEG.TP; also elsewhere on the board
VIN_POS: C4.1, C6.1, IC1.3 (VIN), IC2.3 (VIN), S3.5 (P1), U4.8 (V+), VIN_POS.TP; also elsewhere on the board
~CS: PCB1.8; also elsewhere on the board

Notes on the sheet:
Separate 1V8 lines for analog and digital
Voltage Lines
20MHz Clock
A split supply is needed for op-amps. The Arduino 3V3 rail can be used, in conjuction with the LTC1044 for voltage inversion or two batteries can supply +/-. Switch selects between the two.
Battery Connectors
All other voltages supplied by Arduino/regulators

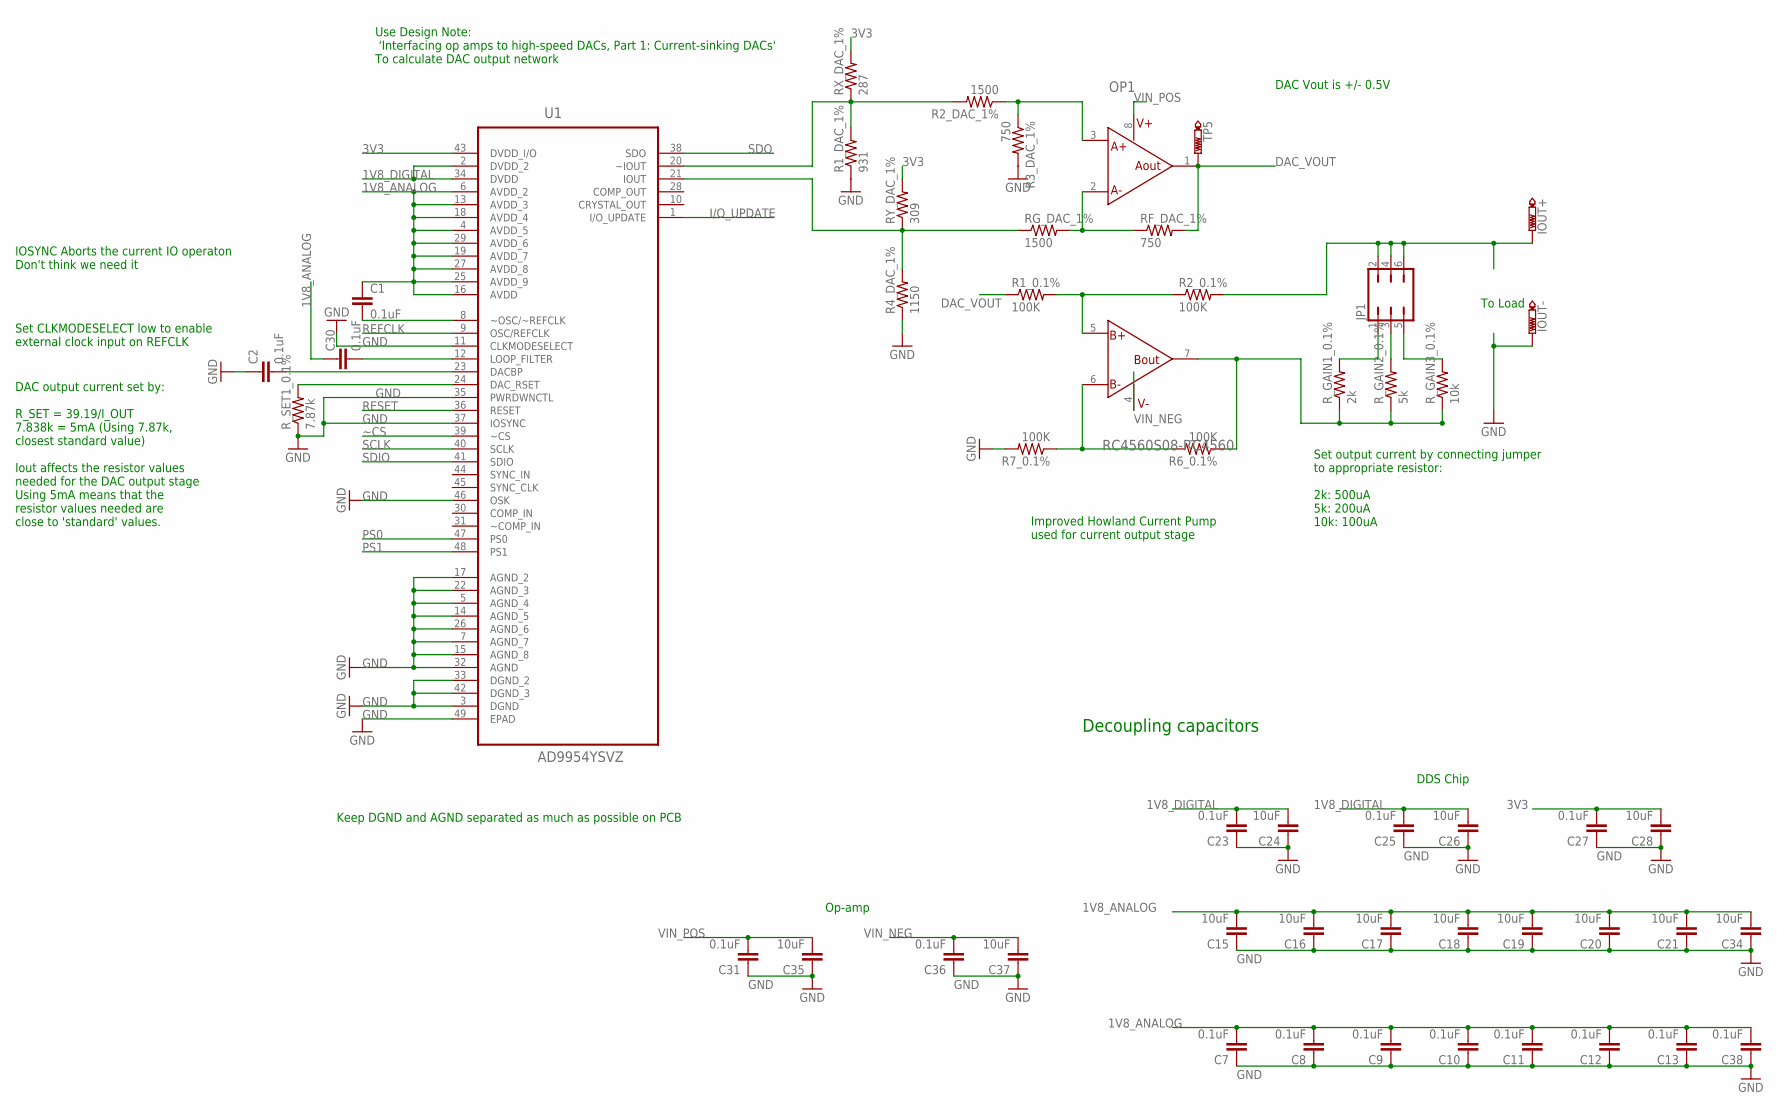
[picture p12: schematic Low.Noise.Current.Source.sch, sheet 2, AD9954]

Parts:
C1, C2, C7, C8, C9, C10, C11, C12, C13, C23, C25, C27, C30, C31, C36, C38: 0.1uF; C0603
C15, C16, C17, C18, C19, C20, C21, C24, C26, C28, C34, C35, C37: 10uF; C0603
IOUT+: PTR1PAD1-13; P1-13
IOUT-: PTR1PAD1-13; P1-13
JP1: JP3Q
OP1: RC4560S08-RC4560; SO8
R1_0.1%, R2_0.1%, R6_0.1%, R7_0.1%: 100K; R0805
R1_DAC_1%: 931; R0805
R2_DAC_1%: 1500; R0805
R3_DAC_1%: 750; R0805
R4_DAC_1%: 1150; R0805
RF_DAC_1%: 750; R0805
RG_DAC_1%: 1500; R0805
RX_DAC_1%: 287; R0805
RY_DAC_1%: 309; R0805
R_GAIN1_0.1%: 2k; R0805
R_GAIN2_0.1%: 5k; R0805
R_GAIN3_0.1%: 10k; R0805
R_SET1_0.1%: 7.87k; R0805
TP5: PTR1PAD1-13; P1-13
U1: AD9954YSVZ; QFP50P900X900X120-49N

Connections:
1V8_ANALOG: C1.1, C7.2, C8.2, C9.2, C10.2, C11.2, C12.2, C13.2, C15.2, C16.2, C17.2, C18.2, C19.2, C20.2, C21.2, C30.1, C34.2, C38.2, U1.4 (AVDD_5), U1.6 (AVDD_2), U1.13 (AVDD_3), U1.16 (AVDD), U1.18 (AVDD_4), U1.19 (AVDD_7), U1.25 (AVDD_9), U1.27 (AVDD_8), U1.29 (AVDD_6); also elsewhere on the board
1V8_DIGITAL: C23.2, C24.2, C25.2, C26.2, U1.2 (DVDD_2), U1.34 (DVDD); also elsewhere on the board
3V3: C27.2, C28.2, RX_DAC_1%.2, RY_DAC_1%.2, U1.43 (DVDD_I/O); also elsewhere on the board
DAC_VOUT: OP1.1 (OUTA), R1_0.1%.1, RF_DAC_1%.2, TP5.TP
GND: C2.1, C7.1, C8.1, C9.1, C10.1, C11.1, C12.1, C13.1, C15.1, C16.1, C17.1, C18.1, C19.1, C20.1, C21.1, C23.1, C24.1, C25.1, C26.1, C27.1, C28.1, C31.1, C34.1, C35.1, C36.1, C37.1, C38.1, IOUT-.TP, R1_DAC_1%.1, R3_DAC_1%.2, R4_DAC_1%.1, R7_0.1%.2, R_SET1_0.1%.1, U1.3 (DGND), U1.5 (AGND_4), U1.7 (AGND_7), U1.11 (CLKMODESELECT), U1.14 (AGND_5), U1.15 (AGND_8), U1.17 (AGND_2), U1.22 (AGND_3), U1.26 (AGND_6), U1.32 (AGND), U1.33 (DGND_2), U1.35 (PWRDWNCTL), U1.37 (IOSYNC), U1.42 (DGND_3), U1.46 (OSK), U1.49 (EPAD); also elsewhere on the board
I/O_UPDATE: U1.1 (I/O_UPDATE); also elsewhere on the board
IOUT: R4_DAC_1%.2, RG_DAC_1%.1, RY_DAC_1%.1, U1.21 (IOUT)
unnamed: C2.2, U1.23 (DACBP)
unnamed: C1.2, U1.8 (~OSC/~REFCLK)
unnamed: R_SET1_0.1%.2, U1.24 (DAC_RSET)
unnamed: OP1.3 (POSA), R2_DAC_1%.1, R3_DAC_1%.1
unnamed: OP1.5 (POSB), R1_0.1%.2, R2_0.1%.1
unnamed: OP1.2 (NEGA), RF_DAC_1%.1, RG_DAC_1%.2
unnamed: OP1.6 (NEGB), R6_0.1%.2, R7_0.1%.1
unnamed: OP1.7 (OUTB), R6_0.1%.1, R_GAIN1_0.1%.1, R_GAIN2_0.1%.1, R_GAIN3_0.1%.1
unnamed: C30.2, U1.12 (LOOP_FILTER)
unnamed: IOUT+.TP, JP1.2, JP1.4, JP1.6, R2_0.1%.2
unnamed: JP1.3, R_GAIN2_0.1%.2
unnamed: JP1.5, R_GAIN3_0.1%.2
unnamed: JP1.1, R_GAIN1_0.1%.2
PS0: U1.47 (PS0); also elsewhere on the board
PS1: U1.48 (PS1); also elsewhere on the board
REFCLK: U1.9 (OSC/REFCLK); also elsewhere on the board
RESET: U1.36 (RESET); also elsewhere on the board
SCLK: U1.40 (SCLK); also elsewhere on the board
SDIO: U1.41 (SDIO); also elsewhere on the board
SDO: U1.38 (SDO); also elsewhere on the board
VIN_NEG: C36.2, C37.2, OP1.4 (V-); also elsewhere on the board
VIN_POS: C31.2, C35.2, OP1.8 (V+); also elsewhere on the board
~CS: U1.39 (~CS); also elsewhere on the board
~IOUT: R1_DAC_1%.2, R2_DAC_1%.2, RX_DAC_1%.1, U1.20 (~IOUT)

Notes on the sheet:
Set CLKMODESELECT low to enable external clock input on REFCLK
DAC output current set by: R_SET = 39.19/I_OUT 7.838k = 5mA (Using 7.87k, closest standard value) Iout affects the resistor values needed for the DAC output stage Using 5mA means that the resistor values needed are close to 'standard' values.
IOSYNC Aborts the current IO operaton Don't think we need it
Decoupling capacitors
Use Design Note: 'Interfacing op amps to high-speed DACs, Part 1: Current-sinking DACs' To calculate DAC output network
Keep DGND and AGND separated as much as possible on PCB
DAC Vout is +/- 0.5V
DDS Chip
Op-amp
Set output current by connecting jumper to appropriate resistor: 2k: 500uA 5k: 200uA 10k: 100uA
To Load
Improved Howland Current Pump used for current output stage

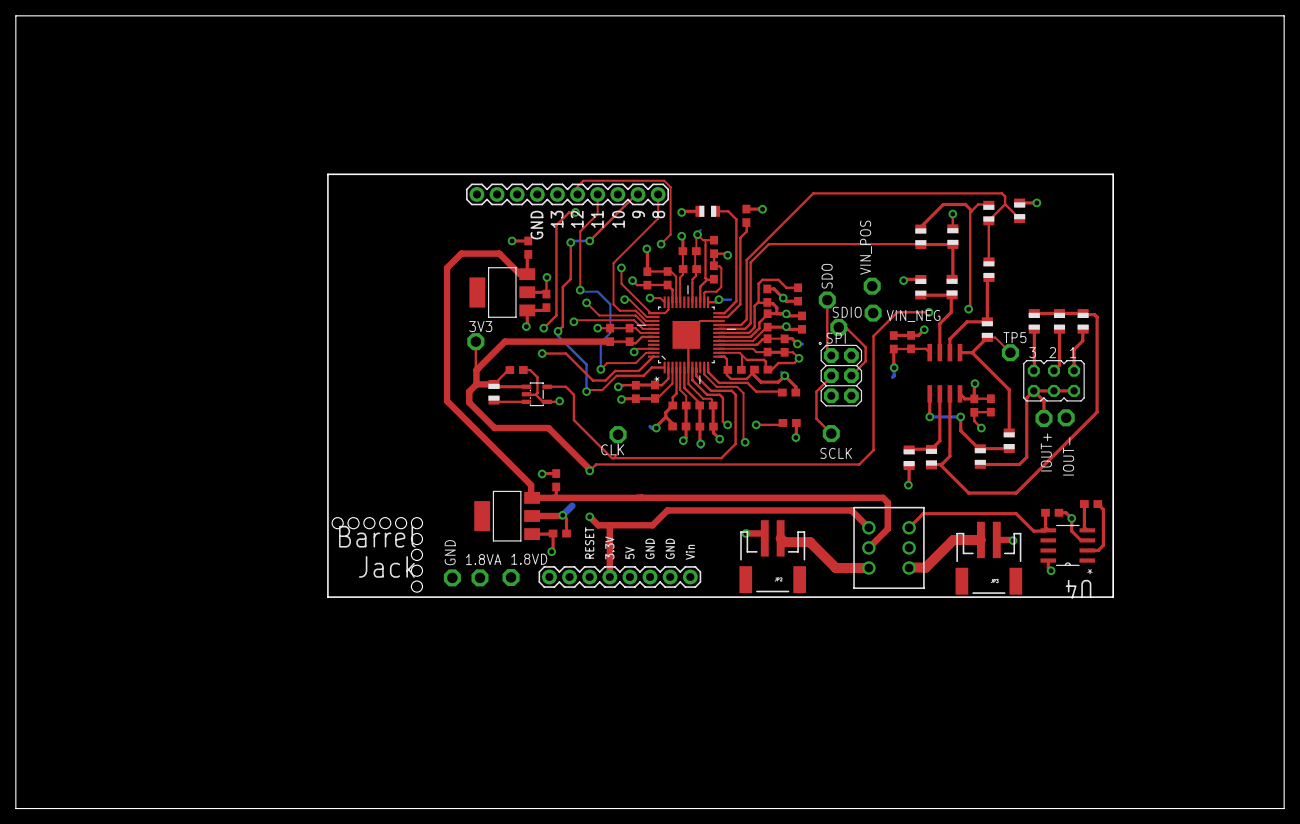
[picture p13: board Low.Noise.Current.Source.brd from above]

Board: 4 copper layers, 160.0 x 100.0 mm, 77 parts (0 on the bottom side), 37 nets.
