EIT-team/AD9954_Current_Source/src/ScouseTom_Control_NOCS/Pins.ino

/*
Stuff for initilalising pins and indicator pins*/

void init_pins()
{
	//Set all pins as outputs and set initial values

	// pins for switching
	pinMode(DINp, OUTPUT);
	pinMode(DINn, OUTPUT);
	pinMode(SCLK, OUTPUT);
	pinMode(SYNC, OUTPUT);
	pinMode(RESET, OUTPUT);

	// pins for testing switch network
	pinMode(TEST_1, INPUT);
	pinMode(TEST_2, INPUT);

	//pins for indicator channels
	pinMode(IND_SWITCH, OUTPUT);
	pinMode(IND_STIM, OUTPUT);
	pinMode(IND_FREQ, OUTPUT);
	pinMode(IND_START, OUTPUT);
	pinMode(IND_STOP, OUTPUT);

	pinMode(IND_EX_1, OUTPUT);
	pinMode(IND_EX_2, OUTPUT);
	pinMode(IND_EX_3, OUTPUT);

	// AD9954 Pins
	pinMode(SS_PIN, OUTPUT);
	pinMode(RESET_PIN, OUTPUT);
	pinMode(UPDATE_PIN, OUTPUT);



	//interupt channels
	//pinMode(INTR_PMARK, INPUT);

	//power pins
	//pinMode(PWR_STIM, OUTPUT);


	//pinMode(LED, OUTPUT);
	//pinMode(fakepmarkpin, OUTPUT);

	//set default values on every pin

}

void reset_pins()
{
	//set all pins to default value - this is called by init but also when stopping injection

	digitalWriteDirect(DINp, LOW);
	digitalWriteDirect(DINn, LOW);
	digitalWriteDirect(SCLK, LOW);
	digitalWriteDirect(SYNC, LOW);
	digitalWriteDirect(RESET, LOW);



}

void reset_ind()
{
	//reset all indicator pins 
	digitalWriteDirect(IND_SWITCH, LOW);
	digitalWriteDirect(IND_STIM, LOW);
	digitalWriteDirect(IND_FREQ, LOW);
	digitalWriteDirect(IND_START, LOW);
	digitalWriteDirect(IND_STOP, LOW);
	digitalWriteDirect(IND_EX_1, LOW);
	digitalWriteDirect(IND_EX_2, LOW);
	digitalWriteDirect(IND_EX_3, HIGH);
}



void reset_pins_pwr()
{
	//reset all power pins
//digitalWrite(PWR_STIM, LOW);

}


void indpins_check() //this checks if there are any pulses left on any of the indicator pins - if not then turn off timer 
{
	if (indpulseson) //if the pulses are apparently on (this is a bit uncessary but used to make this run faster)
	{

		pulsesleft = 0;
		for (pulseleftptr = 0; pulseleftptr < NumInd; pulseleftptr++) // cycle through the pulses left array
		{
			if (pulses[pulseleftptr] > pulsesleft)
			{
				pulsesleft = pulses[pulseleftptr];
			}
		}


		if (pulsesleft == 0) //if none left then turn off the ind timer and set flag low 
		{
			TC_Stop(TC2, 2);
			indpulseson = 0;
			//	Serial.println("stopped ind tc");
		}
	}

}

void indpins_pulse(int StartChn, int StopChn, int SwitchChn, int FreqChn) // this adds pulses to the buffer on each indicator channel 
{
	indpulseson = 1; // set pins on flag

	//add new pulses to array
	pulses[0] += StartChn;
	pulses[1] += StopChn;
	pulses[2] += SwitchChn;
	pulses[3] += FreqChn;
	//	Serial.println("pulsin");
	//start ind pulse timer
	TC_Start(TC2, 2);
}

void indpins_init() //initialise the indicator pins
{
	//reset all variables for indicator pins - this is me being overcautious, these should all be set ok 
	TC_Stop(TC2, 2); // stop ind ISR, just in case

	for (int i = 0; i < NumInd; i++)
	{
		pulses[i] = 0;
		indpinstate[i] = 0;
		IndinterruptCtr[i] = 0;
	}

	iInd = 0; // counter for for loop in ind pins ISR (save defining all the time)
	pulsesleft = 0;
	pulseleftptr = 0;
	indpulseson = 0;
}

void indChnIdent() //pulses to send at start of injections to indicate which indicator pins are which
{
	
	int del = 430;


	//pulse on the dummy channel 
	ind_pulse_with_delay(IND_EX_3, del, 10);

	//separate these from the next ID codes
	delayMicroseconds(del * 5);


	//real ID codes start

	//pulses indicator pins
	indpins_pulse(3, 5, 4, 6); //number of pulses is a bit odd as 4 was used previously on switch chn, so dont want kirill to shout at me for making him change one line of code

	ind_pulse_with_delay(IND_EX_1, del, 7);

	ind_pulse_with_delay(IND_STIM, del, 2);


}

void ind_low()
{
	//set all indicator pins low
	digitalWriteDirect(IND_SWITCH, LOW);
	digitalWriteDirect(IND_STIM, LOW);
	digitalWriteDirect(IND_FREQ, LOW);
	digitalWriteDirect(IND_START, LOW);
	digitalWriteDirect(IND_STOP, LOW);
	digitalWriteDirect(IND_EX_1, LOW);
	digitalWriteDirect(IND_EX_2, LOW);
	digitalWriteDirect(IND_EX_3, LOW);

}

void ind_high()
{
	//set all indicator pins high
	digitalWriteDirect(IND_SWITCH, HIGH);
	digitalWriteDirect(IND_STIM, HIGH);
	digitalWriteDirect(IND_FREQ, HIGH);
	digitalWriteDirect(IND_START, HIGH);
	digitalWriteDirect(IND_STOP, HIGH);
	digitalWriteDirect(IND_EX_1, HIGH);
	digitalWriteDirect(IND_EX_2, HIGH);
	digitalWriteDirect(IND_EX_3, HIGH);
}


void ind_pulse_with_delay(int chn, int del, int repeats)
{
	for (int i = 0; i < repeats; i++)
	{

		digitalWriteDirect(chn, HIGH);
		delayMicroseconds(del);
		digitalWriteDirect(chn, LOW);
		delayMicroseconds(del);

	}
}
