EIT-team/AD9954_Current_Source/tests/Program_AD9954/AD9954.h

/* 
   AD9954.h - AD9954 DDS communication library
   Created by Neal Pisenti, 2013.
   JQI - Strontium - UMD

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

 */

#ifndef AD9954_h
#define AD9954_h

#include "Arduino.h"

class AD9954
{
    public: 
        // Constructor function. 
        AD9954( byte, byte, byte, byte, byte, byte);

        // Initialize with refClk frequency
        void initialize(unsigned long);

        // Initialize with refIn frequency, and clock multiplier value
        void initialize(unsigned long, byte);

        // Reset the DDS
        void reset();

        // Update the new frequency tuning word
        void update();
        

        // Gets current frequency
        unsigned long getFreq();
        // Sets frequency
        void setFreq(unsigned long);

        // Gets current frequency tuning word
        unsigned long getFTW();
        // Sets frequency tuning word
        void setFTW(unsigned long);

        // places DDS in linear sweep mode
        void linearSweep(unsigned long, unsigned long, unsigned long, byte, unsigned long, byte);





    private:
        // Instance variables that hold pinout mapping
        // from arduino to DDS pins.
        byte _ssPin, _resetPin, _updatePin, _ps0, _ps1, _osk;

        // Instance variables for frequency _freq, frequency tuning word _ftw,
        // reference clock frequency _refClk, etc.
        unsigned long _freq, _ftw, _refClk, _refIn;


        // function to write data to register. 
        void writeRegister(byte[2], byte[1024]);


        // DDS frequency resolution
         double RESOLUTION;// = 4294967296; // sets resolution to 2^32 = 32 bits. Using type double to avoid confusion with integer division...



};
 

#endif
