EIT-team/AD9954_Current_Source/(commit log)

2013-02-08 initial commit: arduino - AD9954 DDS communication library
2013-03-27 cleaned up some things; added register command to auto reset phase counter
    [AD9954.cpp]
2013-05-03 added documentation for AD9954, removed Serail.println lines
2014-09-17 fixed issue in AD9954 for static const RESOLUTION
    [AD9954.h]
2014-09-20 Re-fixed issue with AD9954 library, making RESOLUTION a private double and assigning its value in the class constructor.
    Should be stable now. Foolish choices :)
    [AD9954.cpp, AD9954.h]
2017-11-15 added simple fixed current amplitude with no serial comm
    [AD9954.cpp, AD9954.h, Simple_AD9954.ino]
2019-01-07 Added Rev1 Schematics
    [BOM.csv, Low.Noise.Current.Source.bkup.sch, Low.Noise.Current.Source.brd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]
2019-01-10 added reference things for AD9954
    [192593130AD9859_RevD_BOM_Pb_Free.xls, DAC_Sink_to_Op_Amp_Wksht.xls, DAC_Sink_to_Op_Amp_Wksht_Example.xls]
2019-01-15 Added tests for controlling Switch board and doing indicators
2019-01-30 added ref for DAC calculations and ICs used
    [DAC_Sink_to_Op_Amp_Wksht.xls]
2019-01-30 rev2 routing and layout done. still takes too much space
    [ScouseTom_CS_Shield.brd, ScouseTom_CS_Shield.sch]
2019-01-30 layout and some polygons done
    [ScouseTom_CS_Shield.brd]
2019-01-30 no DRC errors
    [ScouseTom_CS_Shield.brd]
2019-02-04 board finished
    [ScouseTom_CS_Shield.brd, ScouseTom_CS_Shield.sch]
2019-06-10 added smaller VDAC out calculation
    [DAC_Sink_to_Op_Amp_Wksht.xls]
2019-06-10 added spice model of DAC network
    [DAC_Sink_to_Op_Amp_Wksht.xls]
2019-06-11 Tests and Simple control for rev2 board
    [DAC_Sink_to_Op_Amp_Wksht.xls, ScouseTom_CS_Shield.sch]
2019-06-13 Simple Control split into separate tabs
    [DAC_Sink_to_Op_Amp_Wksht.xls]
2019-08-19 moved other arduino programs to test
